KyuraNyx/smart-door-lock/assets/statechart_diagram.png

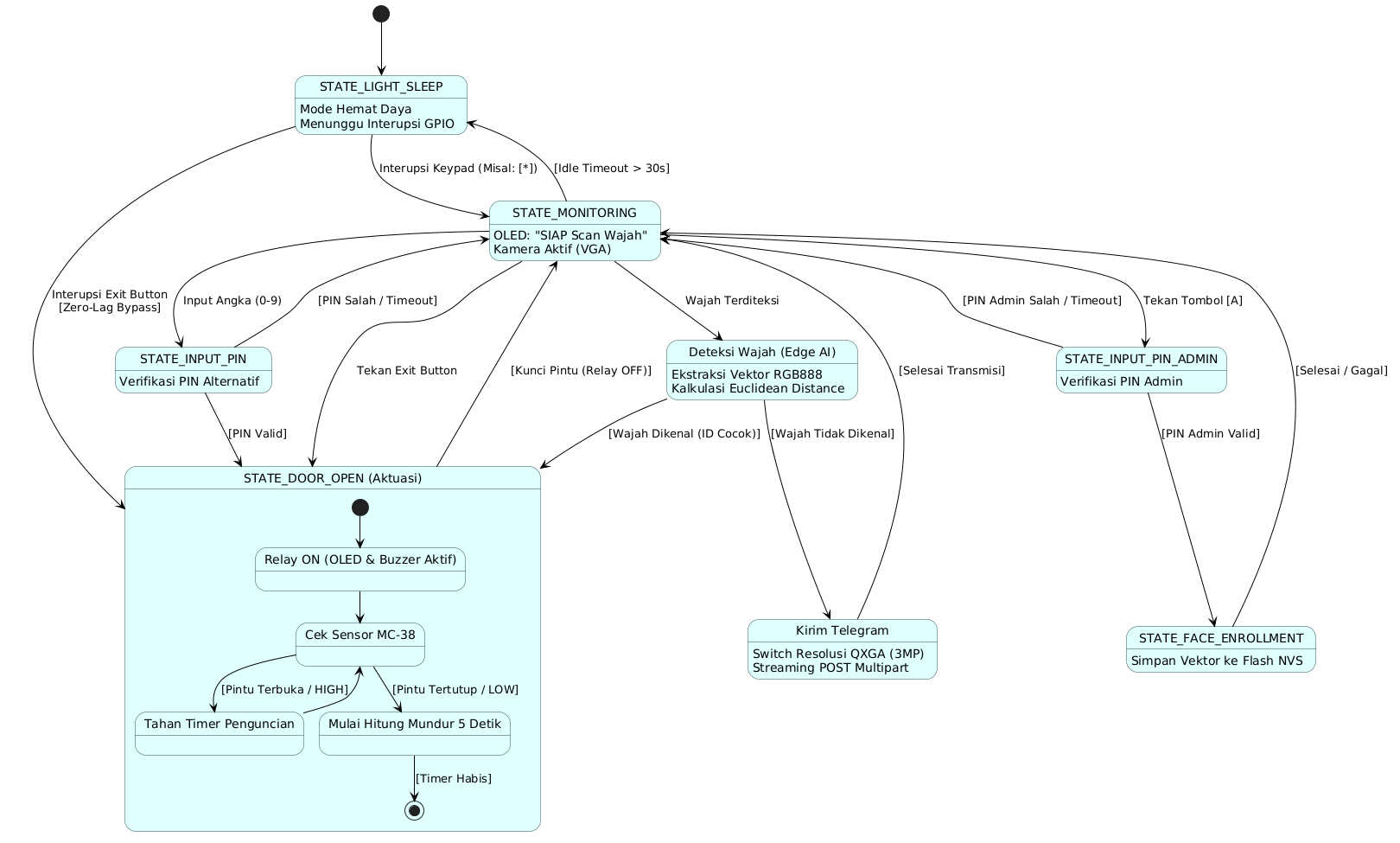
assets/statechart_diagram.png
