KyuraNyx/smart-door-lock/assets/usecase_diagram.png

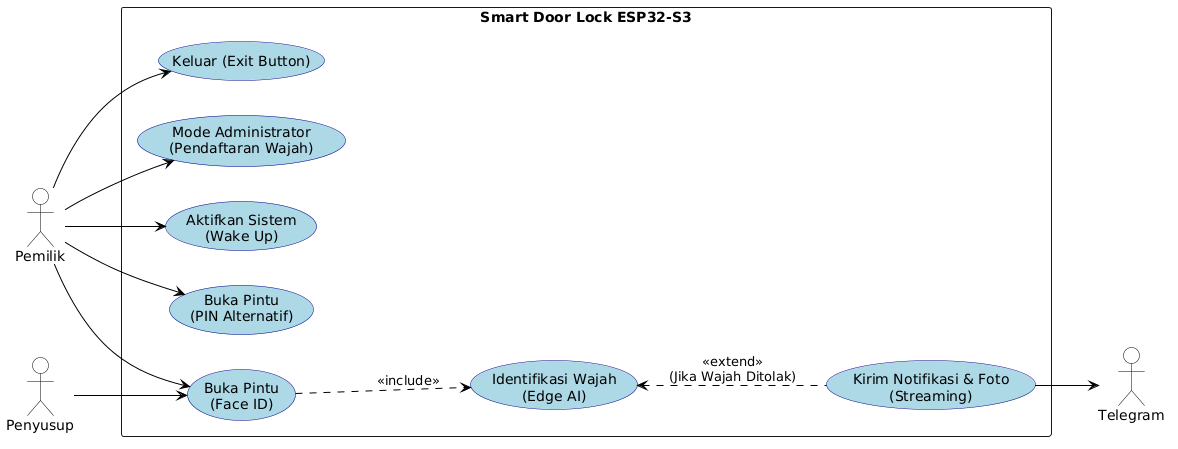
assets/usecase_diagram.png
